abdo2006-dev/Chladni-Plate-Resonance-System/docs/design_notes.md

# Design Notes

## Purpose of the System

This project was built to demonstrate Chladni plate resonance using a controllable electronic excitation source. The aim was not to create a polished commercial device or a measurement-grade laboratory instrument, but to build a working system that could clearly show how changing excitation frequency changes vibration mode shape.

The result is a system that converts a user-selected electrical frequency into visible mechanical patterns on a metal plate.

---

## Core Design Idea

The build can be understood as a chain of energy conversion:

**digital frequency selection -> analog waveform generation -> power amplification -> mechanical vibration -> visible nodal pattern formation**

The electronics were only one part of the project. Their real role was to produce a clean enough drive signal, at sufficient power, to make the plate behave in a predictable and observable way.

---

## Why the DDS Stage Was Important

A Chladni plate only produces strong patterns near resonance. That means the excitation frequency must be adjustable and reasonably stable.

The AD9850 was used because it provides:

- digitally controlled frequency output
- smooth manual adjustment through Arduino control
- sine-wave generation suitable for resonance work
- more repeatable tuning than improvised analog oscillators

This made it possible to explore the plate’s response by entering different frequencies directly.

---

## Why a Sine Wave Was Preferred

A sine wave excites the plate at one dominant frequency. That is important because Chladni patterns are easiest to interpret when one resonance mode dominates the motion.

A waveform with strong harmonics can inject several frequencies into the system at once, which can blur the mode shape or produce less stable particle movement on the plate surface.

For this project, waveform purity mattered more than high signal amplitude at the source, because amplitude could be added later with the power stage.

---

## Why Signal Conditioning Was Necessary

The DDS output was not used directly at the amplifier input. Two interface problems had to be solved first:

1. any unwanted DC content from the source needed to be blocked
2. the amplifier had to be adapted for single-supply operation

This is where the conditioning stage became critical.

The input coupling capacitor removed the DC component from the source signal so that the following stage responded only to the alternating waveform.

The midpoint bias network then shifted that waveform to a reference level compatible with the amplifier’s available supply rails.

Without these steps, the amplifier would not see the signal in the correct operating window.

---

## Single-Supply Constraint

A major design constraint was the available power supply. The amplifier was not operated from a bipolar positive/negative rail arrangement. Instead, the usable supply was a single positive rail with ground.

That meant the waveform could not simply remain centered at 0 V, because the negative half-cycle would push the signal outside the allowable range of the amplifier input.

The workaround was to create a midpoint bias using two equal resistors. This midpoint acted as the signal’s reference level, allowing the waveform to swing around an internal operating point rather than around ground.

This was one of the most important practical design decisions in the project.

---

## Why the LM3875 Was Used

The DDS output alone cannot drive a plate transducer meaningfully. The signal source can define frequency, but not deliver enough power to excite strong mechanical motion.

The LM3875 was therefore used as the power stage because it can provide:

- significantly higher voltage swing
- significantly higher current drive
- practical audio-frequency amplification
- a relatively simple external circuit

In this project, the amplifier was not the source of intelligence or control. Its role was to take an already-correct signal and make it physically useful.

---

## Mechanical Side of the Project

The Chladni plate itself is part of the system, not just the “output display.”

The final visible pattern depends on:

- plate shape
- mounting condition
- transducer coupling
- vibration amplitude
- excitation frequency
- particle distribution on the plate

Because of this, the electronics and mechanics cannot be treated separately. A well-designed signal chain still produces poor results if the plate mounting or exciter coupling is weak or inconsistent.

---

## What Was Learned

This project reinforced several practical ideas:

- signal quality matters before gain matters
- a source and an amplifier cannot always be connected directly
- single-supply systems require deliberate biasing choices
- resonance demonstrations are highly sensitive to both electrical and mechanical setup
- visible results can be a powerful way to validate an electronics system

---

## Limitations

This was a demonstration build, not a formal characterization platform.

The project did not include:

- automated frequency sweep logging
- calibrated vibration measurements
- modal identification software
- quantified efficiency or distortion testing
- a PCB-based final hardware revision

That is acceptable, because the objective was functional demonstration rather than precision instrumentation.

---

## Possible Next Steps

Natural extensions of the project include:

- adding a display for current frequency
- implementing a controlled sweep mode
- storing useful resonance frequencies as presets
- redesigning the amplifier and conditioning stages on a PCB
- comparing different plate shapes and mounting methods
- documenting a larger library of observed Chladni modes

---

## Repository Intent

This repository is meant to document the engineering logic behind the build, not just store files. It should show how the project was conceived, adapted, and demonstrated, even though the code footprint is small.
