abdo2006-dev/Chladni-Plate-Resonance-System/images/Arduino_and_AD9850_connections.jpg

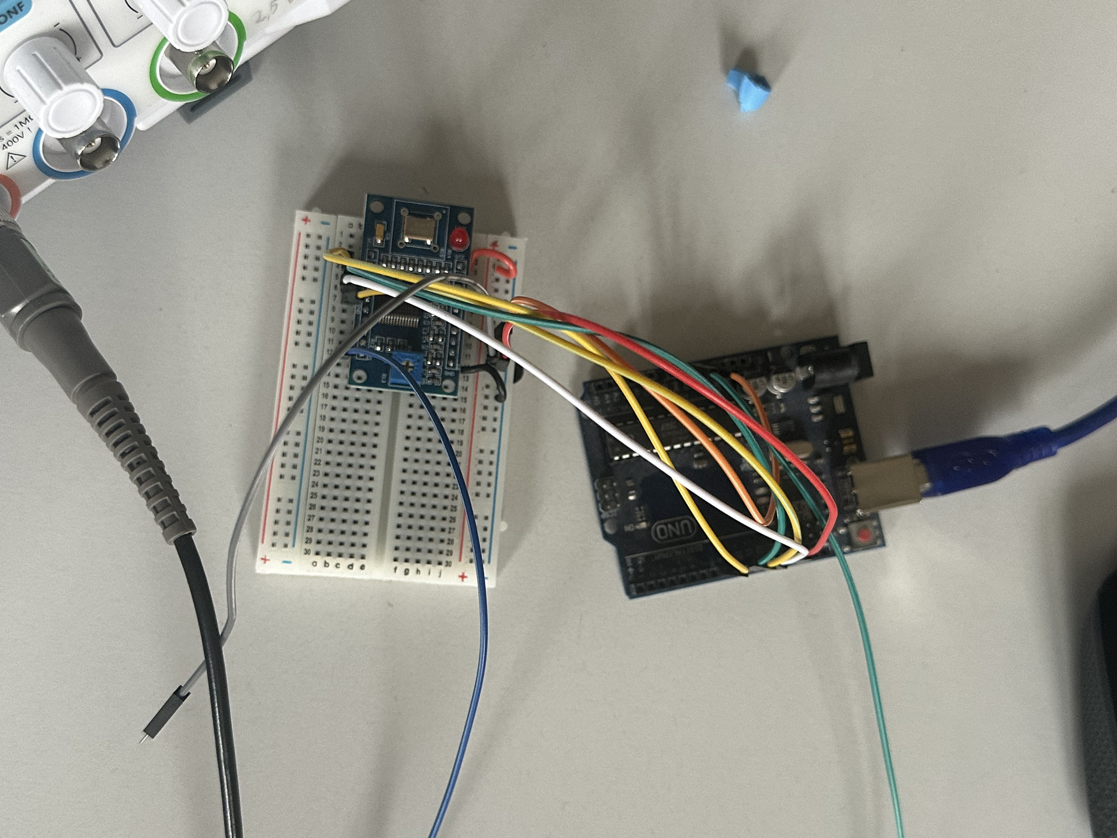
images/Arduino_and_AD9850_connections.jpg
