abdo2006-dev/Chladni-Plate-Resonance-System/images/output_coupling_capacitors.jpg

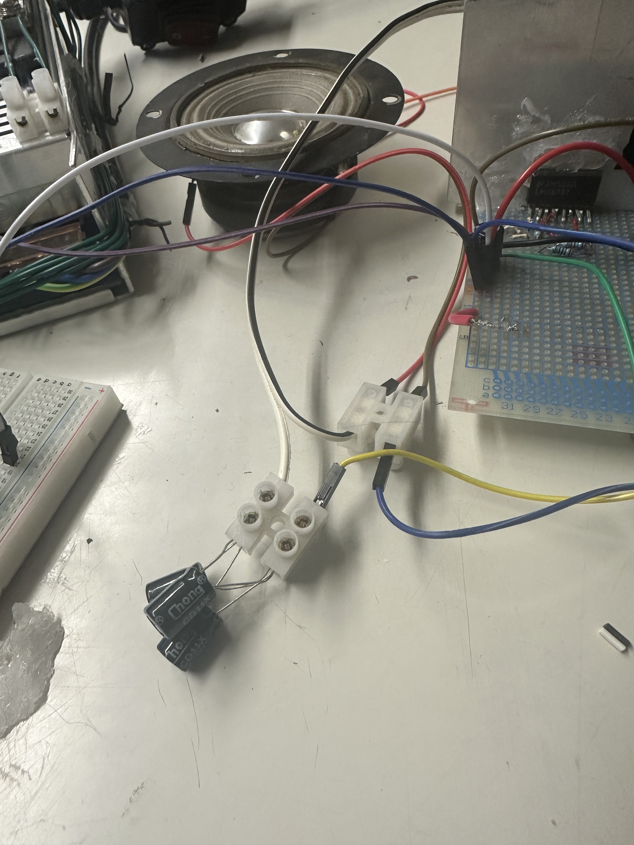
images/output_coupling_capacitors.jpg
