abdo2006-dev/Chladni-Plate-Resonance-System/schematics/lm3875_typical_application.png

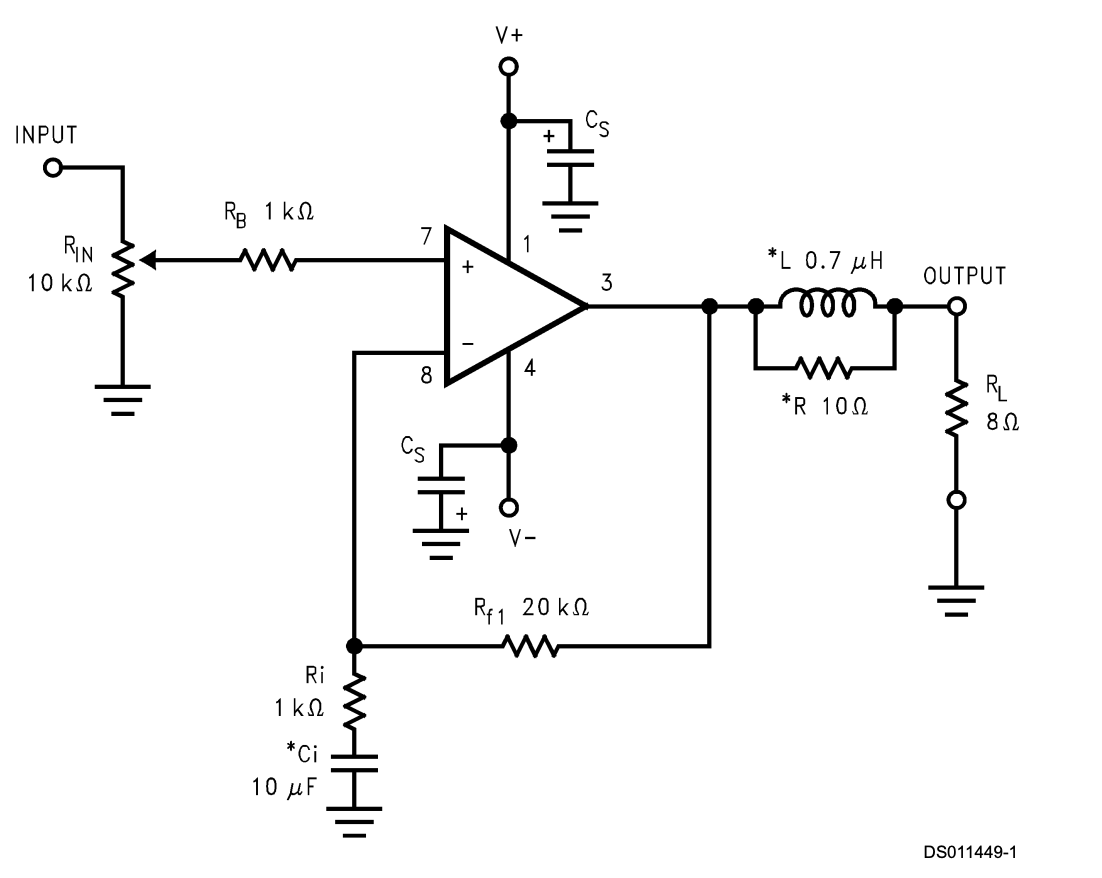
schematics/lm3875_typical_application.png
