abdo2006-dev/Chladni-Plate-Resonance-System/schematics/arduino_ad9850_wiring.jpeg

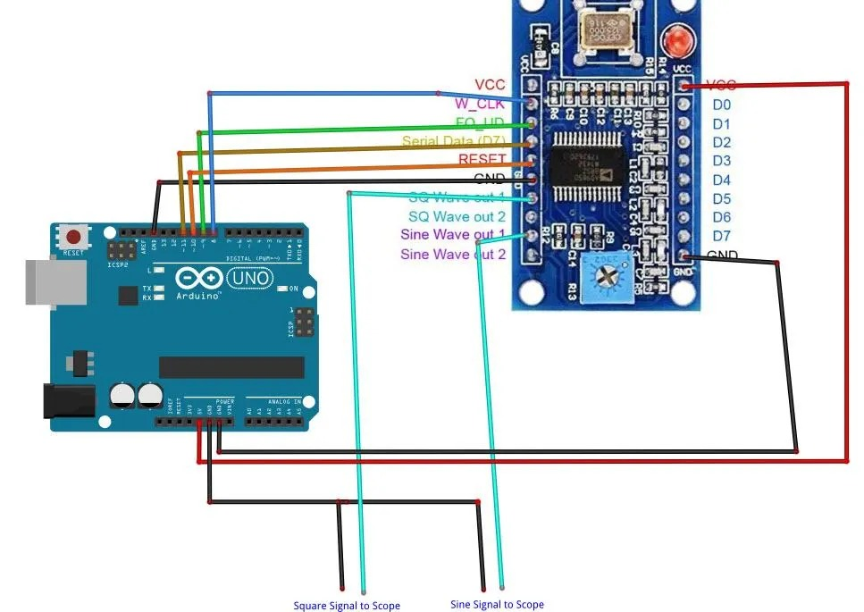
schematics/arduino_ad9850_wiring.jpeg
