abdo2006-dev/Chladni-Plate-Resonance-System/(commit log)

2026-04-21 added schematic images
2026-08-02 Redesign repository as an engineering portfolio case study
    Redesigns the README as an engineering case study with real image/oscilloscope
    evidence and a system-architecture diagram; adds docs/ covering hardware,
    firmware, experiment results, engineering decisions, and project scope;
    clarifies team vs. individual contributions; improves repository hygiene
    (gitignore, untracked .DS_Store, fixed filename); adds a LICENSE with
    CC BY 4.0 for docs/report/photos. Private interview-prep material stays
    outside version control.
